mox-mox/moxens_ceiling_lamp/datasheets/AVR mit BTM-222 Class1 Bluetooth-Modul mit SPP firmware_files/USB-to-TTL-RS232-Converter_V2.jpg

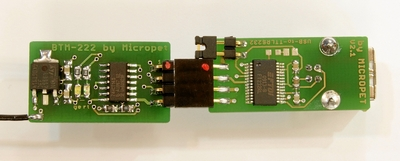
datasheets/AVR mit BTM-222 Class1 Bluetooth-Modul mit SPP firmware_files/USB-to-TTL-RS232-Converter_V2.jpg
