mox-mox/moxens_ceiling_lamp/README.md

moxens_ceiling_lamp
===================

This is the source to the lamp that is to light my room
