mox-mox/moxens_ceiling_lamp/datasheets/AVR mit BTM-222 Class1 Bluetooth-Modul mit SPP firmware_files/Basisboard%20BTM-222%20V2.png

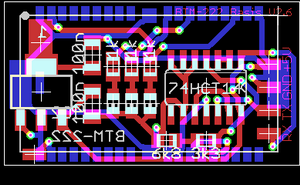
datasheets/AVR mit BTM-222 Class1 Bluetooth-Modul mit SPP firmware_files/Basisboard%20BTM-222%20V2.png
