mox-mox/moxens_ceiling_lamp/datasheets/AVR mit BTM-222 Class1 Bluetooth-Modul mit SPP firmware_files/Basisboard%2520BTM-222%2520V2_002.png

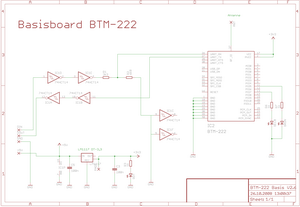
datasheets/AVR mit BTM-222 Class1 Bluetooth-Modul mit SPP firmware_files/Basisboard%2520BTM-222%2520V2_002.png
