mox-mox/moxens_ceiling_lamp/datasheets/AVR mit BTM-222 Class1 Bluetooth-Modul mit SPP firmware_files/BTM-222-Wannenstecker_02_m.jpg

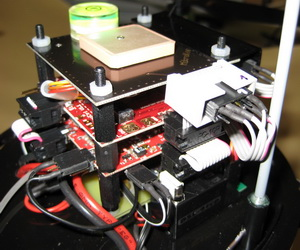
datasheets/AVR mit BTM-222 Class1 Bluetooth-Modul mit SPP firmware_files/BTM-222-Wannenstecker_02_m.jpg
