mox-mox/moxens_ceiling_lamp/hardware/Board.png

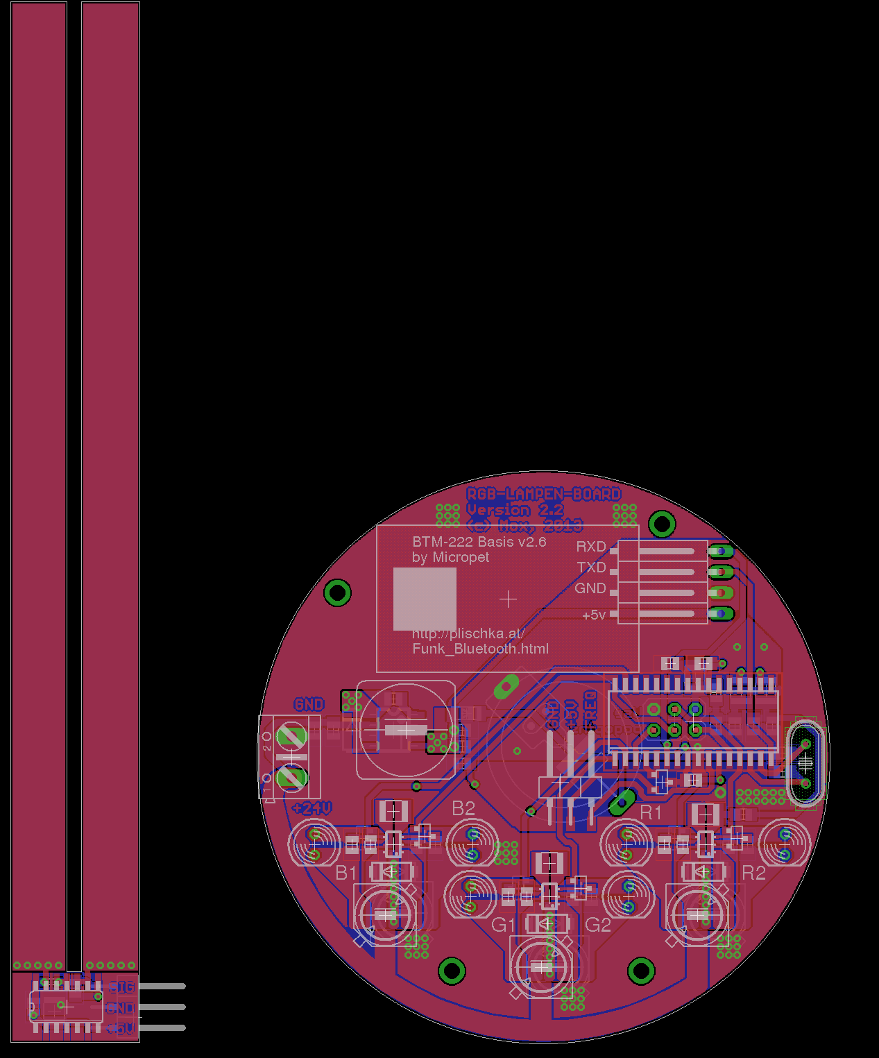
hardware/Board.png
