mox-mox/moxens_ceiling_lamp/hardware/plan.png

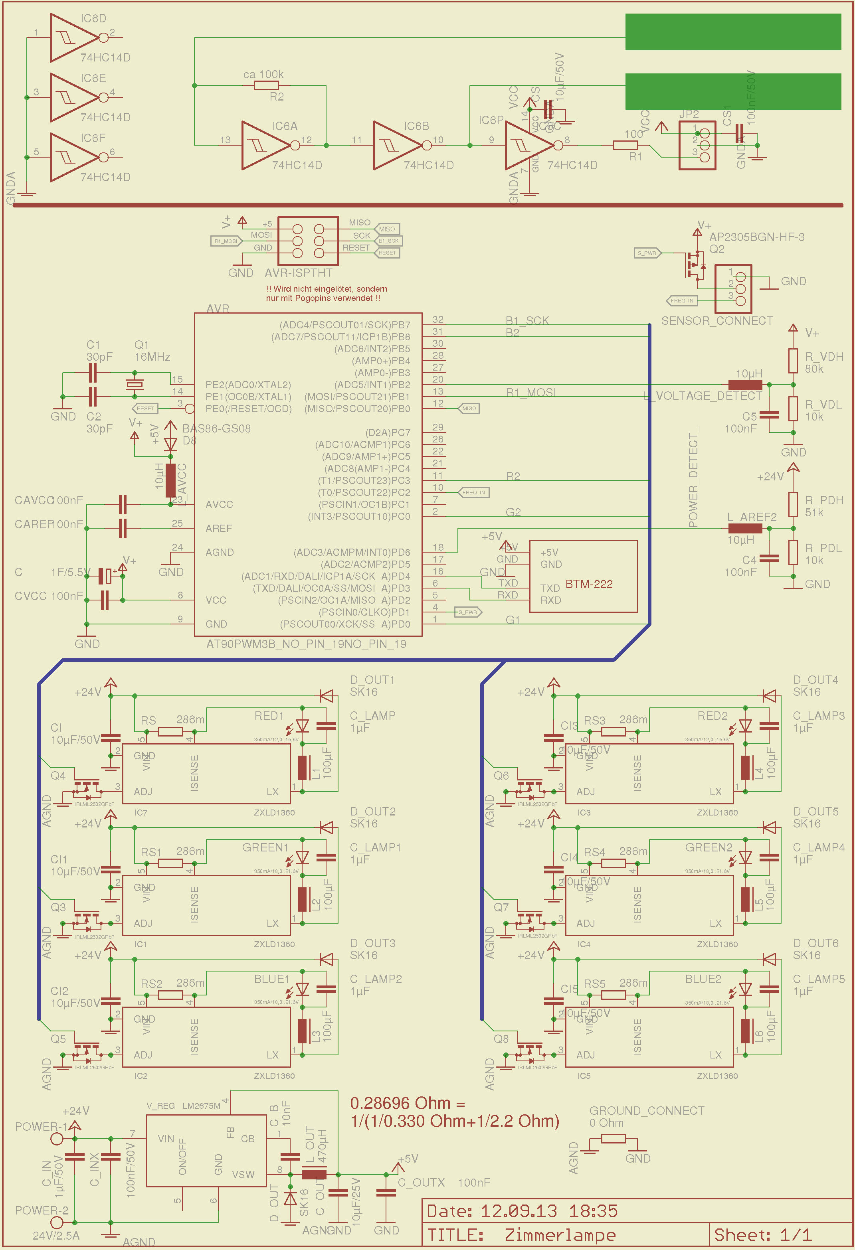
hardware/plan.png
