mox-mox/moxens_ceiling_lamp/hardware/Zimmerlampe_3.brd

## EAGLE design hardware/Zimmerlampe_3.brd (2014-02-08)

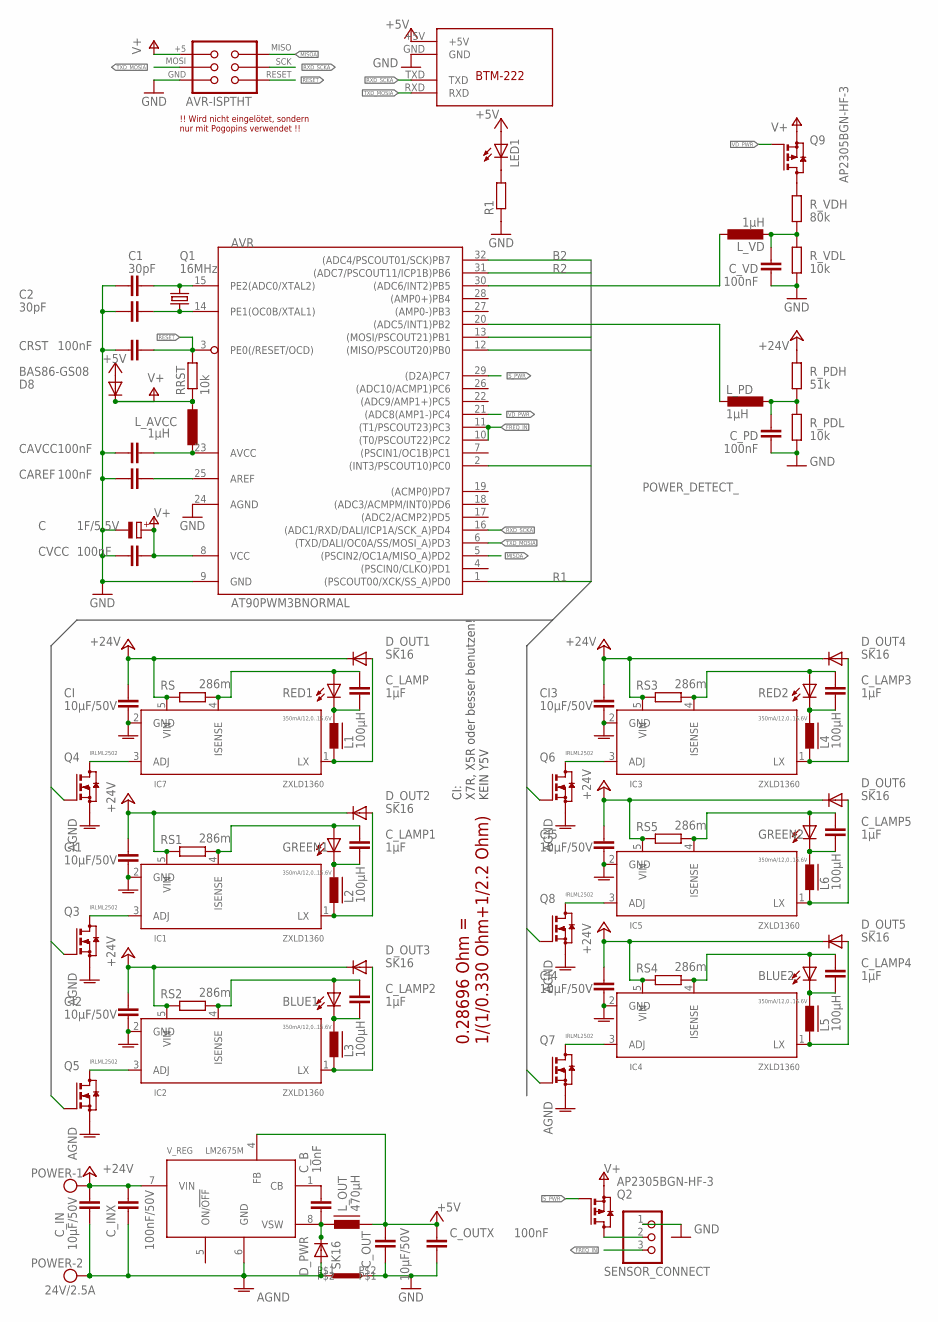
[picture p23: schematic Zimmerlampe_3.sch]

Parts:
AVR: AT90PWM3BNORMAL; SO32W
BLUE1, BLUE2: 350mA/12,0..15.6V; LED_CON
C: 1F/5.5V; PANASONIC_SG_TERMINAL_H
C1, C2: 30pF; C0805
CAREF: 100nF; C0805
CAVCC: 100nF; C0805
CI, CI1, CI2, CI3, CI4, CI5: 10µF/50V; C1210
CRST: 100nF; C0805
CVCC: 100nF; C0805
C_B: 10nF; C0805
C_IN: 10µF/50V; C1210
C_INX: 100nF/50V; C0805
C_LAMP, C_LAMP1, C_LAMP2, C_LAMP3, C_LAMP4, C_LAMP5: 1µF; C0805
C_OUT: 10µF/50V; C1210
C_OUTX: 100nF; C0805
C_PD: 100nF; C0805
C_VD: 100nF; C0805
D8: BAS86-GS08; MINIMELF
D_OUT1, D_OUT2, D_OUT3, D_OUT4, D_OUT5, D_OUT6: SK16; DO214AA
D_PWR: SK16; DO214AA
GREEN1, GREEN2: 350mA/12,0..15.6V; LED_CON
IC1, IC2, IC3, IC4, IC5, IC7: ZXLD1360; TSOT23-5
L1, L2, L3, L4, L5, L6: 100µH; FERROCORE_DER0705-
LED1: LEDSML0805; SML0805
L_AVCC: 1µH; L0805
L_OUT: 470µH; FERROCORE_DE1207-
L_PD: 1µH; L0805
L_VD: 1µH; L0805
POWER: 24V/2.5A; AK500/2
Q1: 16MHz; HC49/S
Q2, Q9: AP2305BGN-HF-3; SOT23
Q3, Q4, Q5, Q6, Q7, Q8: IRLML2502; SOT23
R1: R-EU_R0805; R0805
RED1, RED2: 350mA/12,0..15.6V; LED_CON
RRST: 10k; R0805
RS, RS1, RS2, RS3, RS4, RS5: 286m; R0805
R_PDH: 51k; R0805
R_PDL: 10k; R0805
R_VDH: 80k; R0805
R_VDL: 10k; R0805
SENSOR_CONNECT: 1X03SMD/90
U$1: BTM-222-BASIS; BTM-222
U$3: STARPOINT
U$7: AVR-ISPTHT; AVR-ISP-THT
V_REG: LM2675M; SO08

Connections:
+5V: C_OUT.1, C_OUTX.1, D8.A, LED1.A, L_OUT.P$2 (2), U$1.+5V, V_REG.4 (FB)
+24V: CI.1, CI1.1, CI2.1, CI3.1, CI4.1, CI5.1, C_IN.1, C_INX.1, D_OUT1.C, D_OUT2.C, D_OUT3.C, D_OUT4.C, D_OUT5.C, D_OUT6.C, IC1.5 (VIN), IC2.5 (VIN), IC3.5 (VIN), IC4.5 (VIN), IC5.5 (VIN), IC7.5 (VIN), POWER.1, RS.1, RS1.1, RS2.1, RS3.1, RS4.1, RS5.1, R_PDH.1, V_REG.7 (VIN)
ADJUST: IC7.3 (ADJ), Q4.3 (D)
ADJUST1: IC1.3 (ADJ), Q3.3 (D)
ADJUST2: IC2.3 (ADJ), Q5.3 (D)
ADJUST3: IC3.3 (ADJ), Q6.3 (D)
ADJUST4: IC4.3 (ADJ), Q7.3 (D)
ADJUST5: IC5.3 (ADJ), Q8.3 (D)
AGND: CI.2, CI1.2, CI2.2, CI3.2, CI4.2, CI5.2, C_IN.2, C_INX.2, D_PWR.A, IC1.2 (GND), IC2.2 (GND), IC3.2 (GND), IC4.2 (GND), IC5.2 (GND), IC7.2 (GND), POWER.2, Q3.2 (S), Q4.2 (S), Q5.2 (S), Q6.2 (S), Q7.2 (S), Q8.2 (S), U$3.P$1, V_REG.6 (GND)
AREF: AVR.25 (AREF), CAREF.2
AVCC: AVR.23 (AVCC), CAVCC.2, L_AVCC.1
B1: AVR.13 ((MOSI/PSCOUT21)PB1), Q5.1 (G)
B2: AVR.32 ((ADC4/PSCOUT01/SCK)PB7), Q7.1 (G)
BLUE2: BLUE2.A, C_LAMP4.1, IC4.4 (ISENSE), RS4.2
FREEWHEEL: D_OUT1.A, IC7.1 (LX), L1.P$2 (2)
FREEWHEEL1: D_OUT2.A, IC1.1 (LX), L2.P$2 (2)
FREEWHEEL2: D_OUT3.A, IC2.1 (LX), L3.P$2 (2)
FREEWHEEL3: D_OUT4.A, IC3.1 (LX), L4.P$2 (2)
FREEWHEEL4: D_OUT5.A, IC4.1 (LX), L5.P$2 (2)
FREEWHEEL5: D_OUT6.A, IC5.1 (LX), L6.P$2 (2)
FREQ_IN: AVR.10 ((T0/PSCOUT22)PC2), AVR.11 ((T1/PSCOUT23)PC3), SENSOR_CONNECT.3
G1: AVR.12 ((MISO/PSCOUT20)PB0), Q3.1 (G)
G2: AVR.2 ((INT3/PSCOUT10)PC0), Q8.1 (G)
GND: AVR.9 (GND), AVR.24 (AGND), C.-, C1.1, C2.1, CAREF.1, CAVCC.1, CRST.1, CVCC.1, C_OUT.2, C_OUTX.2, C_PD.2, C_VD.2, R1.1, R_PDL.2, R_VDL.2, SENSOR_CONNECT.1, U$1.GND, U$3.P$2, U$7.6 (GND)
MISOA: AVR.5 ((PSCIN2/OC1A/MISO_A)PD2), U$7.1 (MISO)
unnamed: LED1.C, R1.2
unnamed: C_LAMP.1, IC7.4 (ISENSE), RED1.A, RS.2
unnamed: C_LAMP.2, L1.P$1 (1), RED1.C
unnamed: Q9.2 (D), R_VDH.1
unnamed: C_LAMP1.2, GREEN1.C, L2.P$1 (1)
unnamed: C_LAMP1.1, GREEN1.A, IC1.4 (ISENSE), RS1.2
unnamed: BLUE1.C, C_LAMP2.2, L3.P$1 (1)
unnamed: BLUE1.A, C_LAMP2.1, IC2.4 (ISENSE), RS2.2
unnamed: C_LAMP3.2, L4.P$1 (1), RED2.C
unnamed: C_LAMP3.1, IC3.4 (ISENSE), RED2.A, RS3.2
unnamed: BLUE2.C, C_LAMP4.2, L5.P$1 (1)
unnamed: C_LAMP5.2, GREEN2.C, L6.P$1 (1)
unnamed: C_LAMP5.1, GREEN2.A, IC5.4 (ISENSE), RS5.2
unnamed: C_B.1, V_REG.1 (CB)
unnamed: Q2.2 (D), SENSOR_CONNECT.2
POWER_DETECT: C_PD.1, L_PD.1, R_PDH.2, R_PDL.1
POWER_DETECT_: AVR.20 ((ADC5/INT1)PB2), L_PD.2
R1: AVR.1 ((PSCOUT00/XCK/SS_A)PD0), Q4.1 (G)
R2: AVR.31 ((ADC7/PSCOUT11/ICP1B)PB6), Q6.1 (G)
RESET: AVR.3 (PE0(/RESET/OCD)), CRST.2, RRST.2, U$7.5 (RESET)
RXD_SCKA: AVR.16 ((ADC1/RXD/DALI/ICP1A/SCK_A)PD4), U$1.TXD, U$7.3 (SCK)
SWITCH: C_B.2, D_PWR.C, L_OUT.P$1 (1), V_REG.8 (VSW)
S_PWR: AVR.29 ((D2A)PC7), Q2.1 (G)
TXD_MOSIA: AVR.6 ((TXD/DALI/OC0A/SS/MOSI_A)PD3), U$1.RXD, U$7.4 (MOSI)
V+: AVR.8 (VCC), C.+, CVCC.2, D8.C, L_AVCC.2, Q2.3 (S), Q9.3 (S), RRST.1, U$7.2 (+5)
VD_PWR: AVR.21 ((ADC8(AMP1-)PC4), Q9.1 (G)
VOLTAGE_DETECT: C_VD.1, L_VD.2, R_VDH.2, R_VDL.1
VOLTAGE_DETECT_: AVR.30 ((ADC6/INT2)PB5), L_VD.1
XTAL1: AVR.14 (PE1(OC0B/XTAL1)), C2.2, Q1.2
XTAL2: AVR.15 (PE2(ADC0/XTAL2)), C1.2, Q1.1

Notes on the sheet:
0.28696 Ohm = 1/(1/0.330 Ohm+1/2.2 Ohm)
!! Wird nicht eingelötet, sondern nur mit Pogopins verwendet !!
CI: X7R, X5R oder besser benutzen! KEIN Y5V

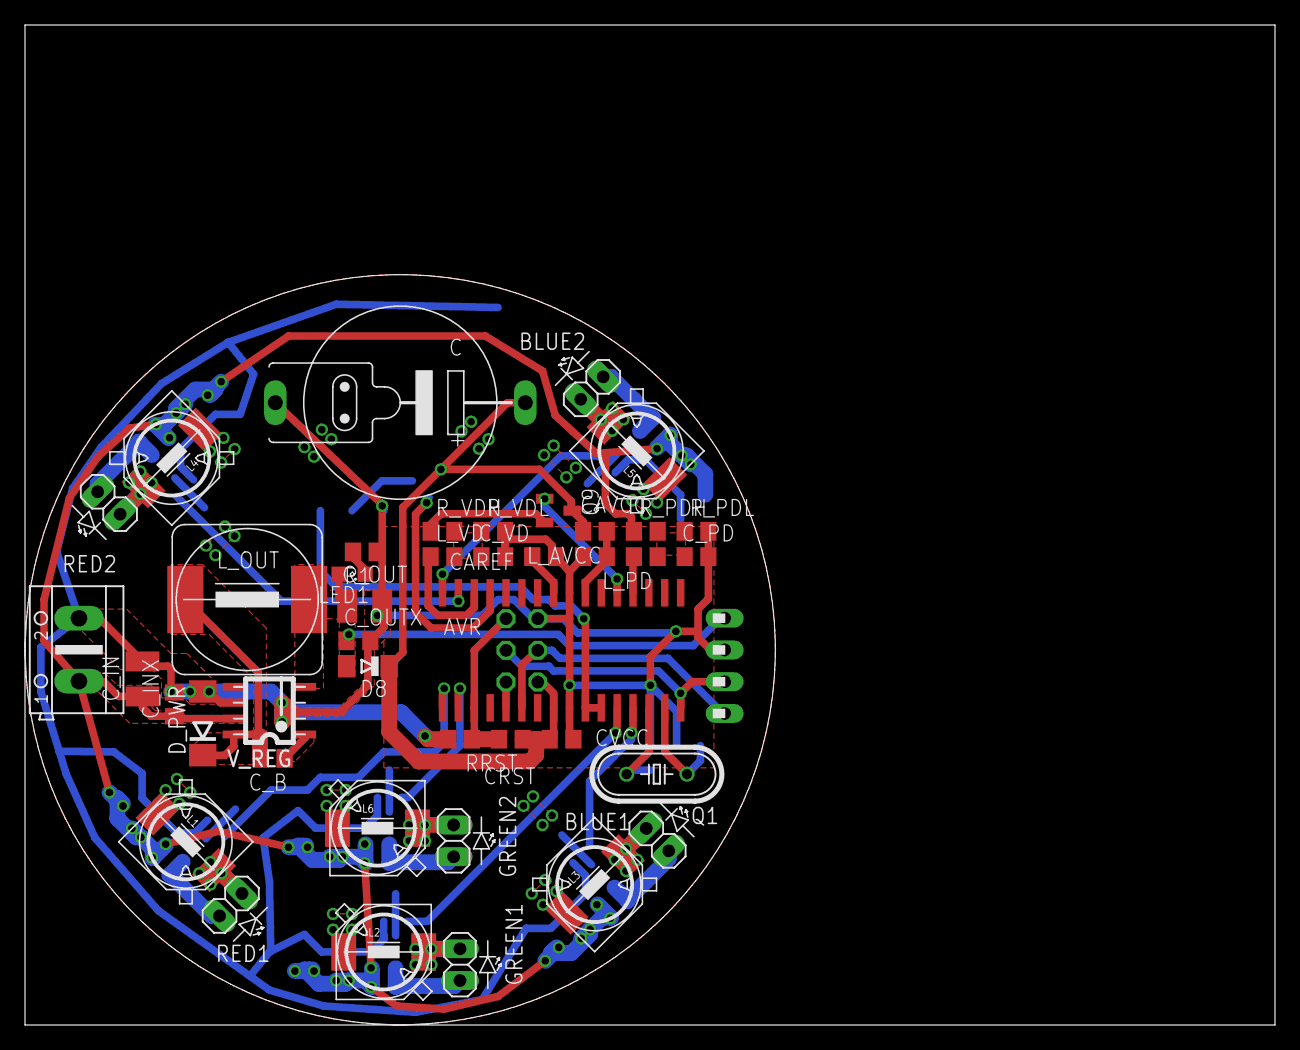
[picture p24: board Zimmerlampe_3.brd from above]

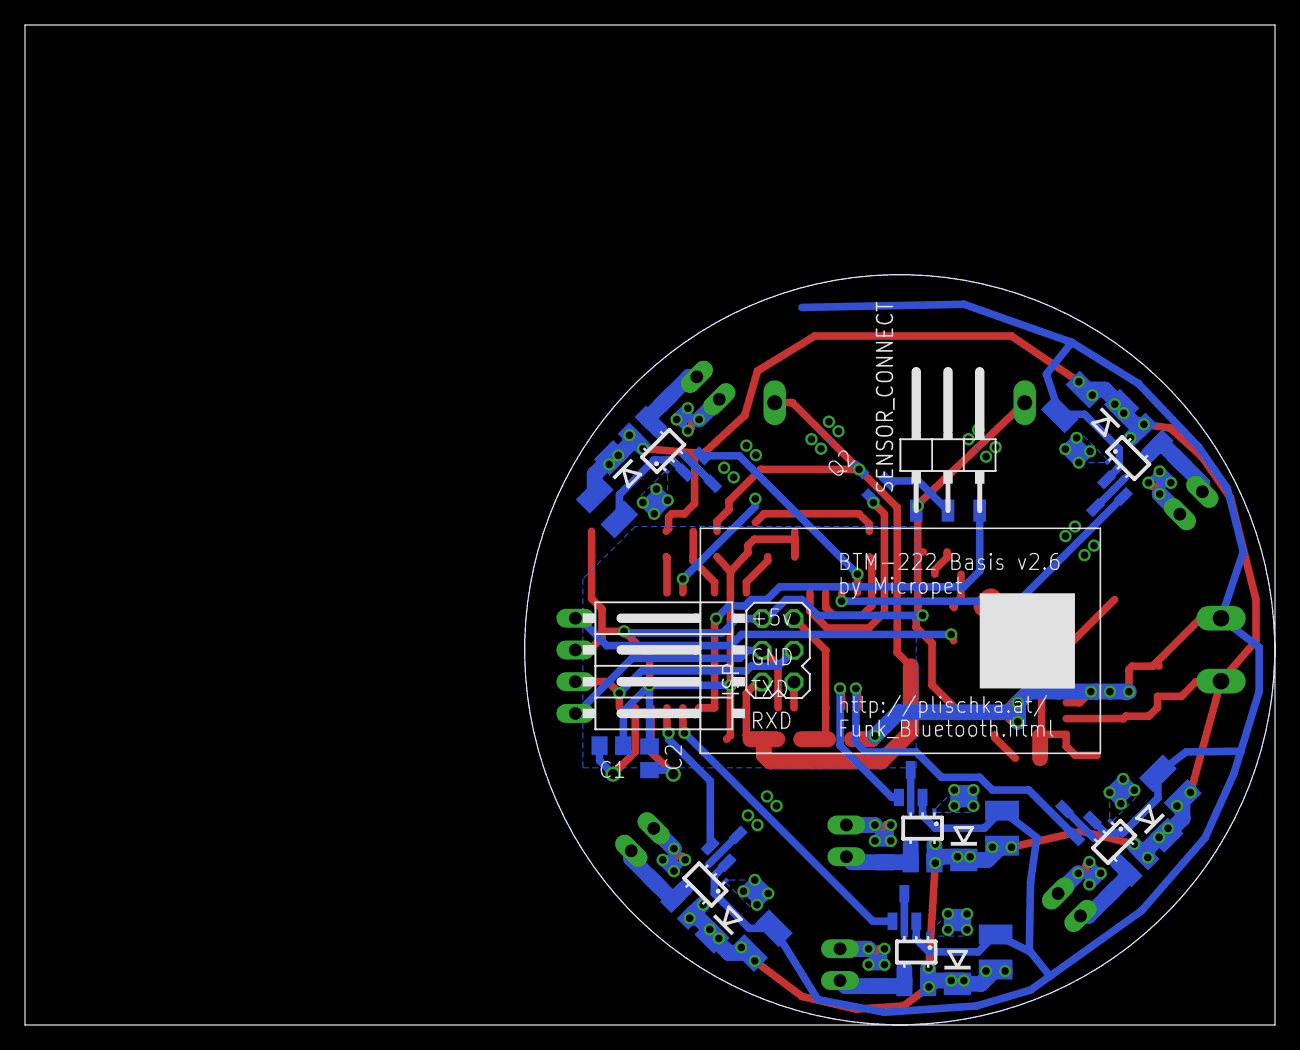
[picture p25: board Zimmerlampe_3.brd from below]

Board: 2 copper layers, 100.0 x 80.0 mm, 85 parts (43 on the bottom side), 55 nets.
