mox-mox/moxens_ceiling_lamp/hardware/Feuchtesensor_Frequenz.brd

## EAGLE design hardware/Feuchtesensor_Frequenz.brd (2014-01-29)

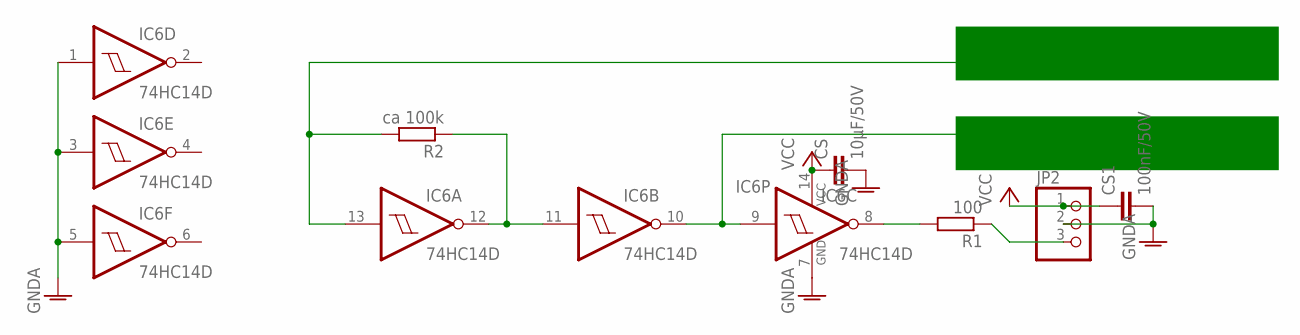
[picture p26: schematic Feuchtesensor_Frequenz.sch]

Parts:
CS: 10µF/50V; C1210
CS1: 100nF/50V; C0805
IC6: 74HC14D; SO14
JP2: 1X03SMD/90
R1: 100; R0805
R2: ca 100k; R0603

Connections:
GNDA: CS.2, CS1.2, IC6.1 (I), IC6.3 (I), IC6.5 (I), IC6.7 (GND), JP2.2
unnamed: IC6.13 (I), R2.2
unnamed: IC6.11 (I), IC6.12 (O), R2.1
unnamed: IC6.9 (I), IC6.10 (O)
SIG: JP2.3, R1.1
SIG_: IC6.8 (O), R1.2
VCC: CS.1, CS1.1, IC6.14 (VCC), JP2.1

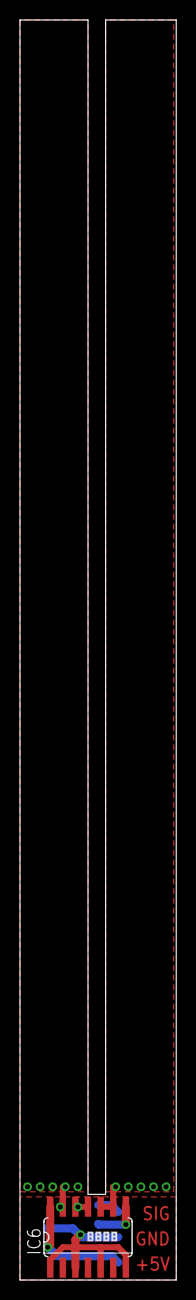
[picture p27: board Feuchtesensor_Frequenz.brd from above]

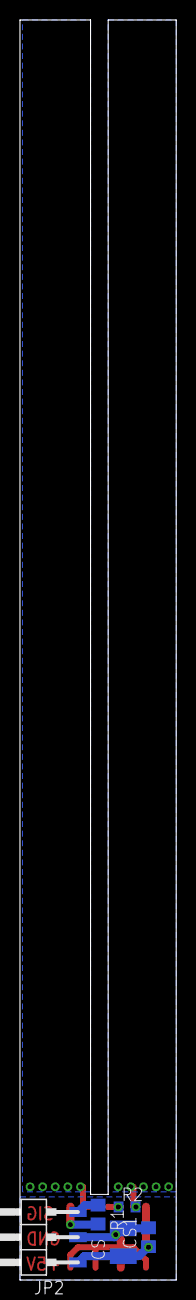
[picture p28: board Feuchtesensor_Frequenz.brd from below]

Board: 2 copper layers, 15.7 x 127.0 mm, 7 parts (5 on the bottom side), 7 nets.

Other parts of the board:
U$2: LP_NUMBER_SILK_TOP
