mox-mox/moxens_ceiling_lamp/hardware/Zimmerlampe_6.brd

## EAGLE design hardware/Zimmerlampe_6.brd (2014-02-27)

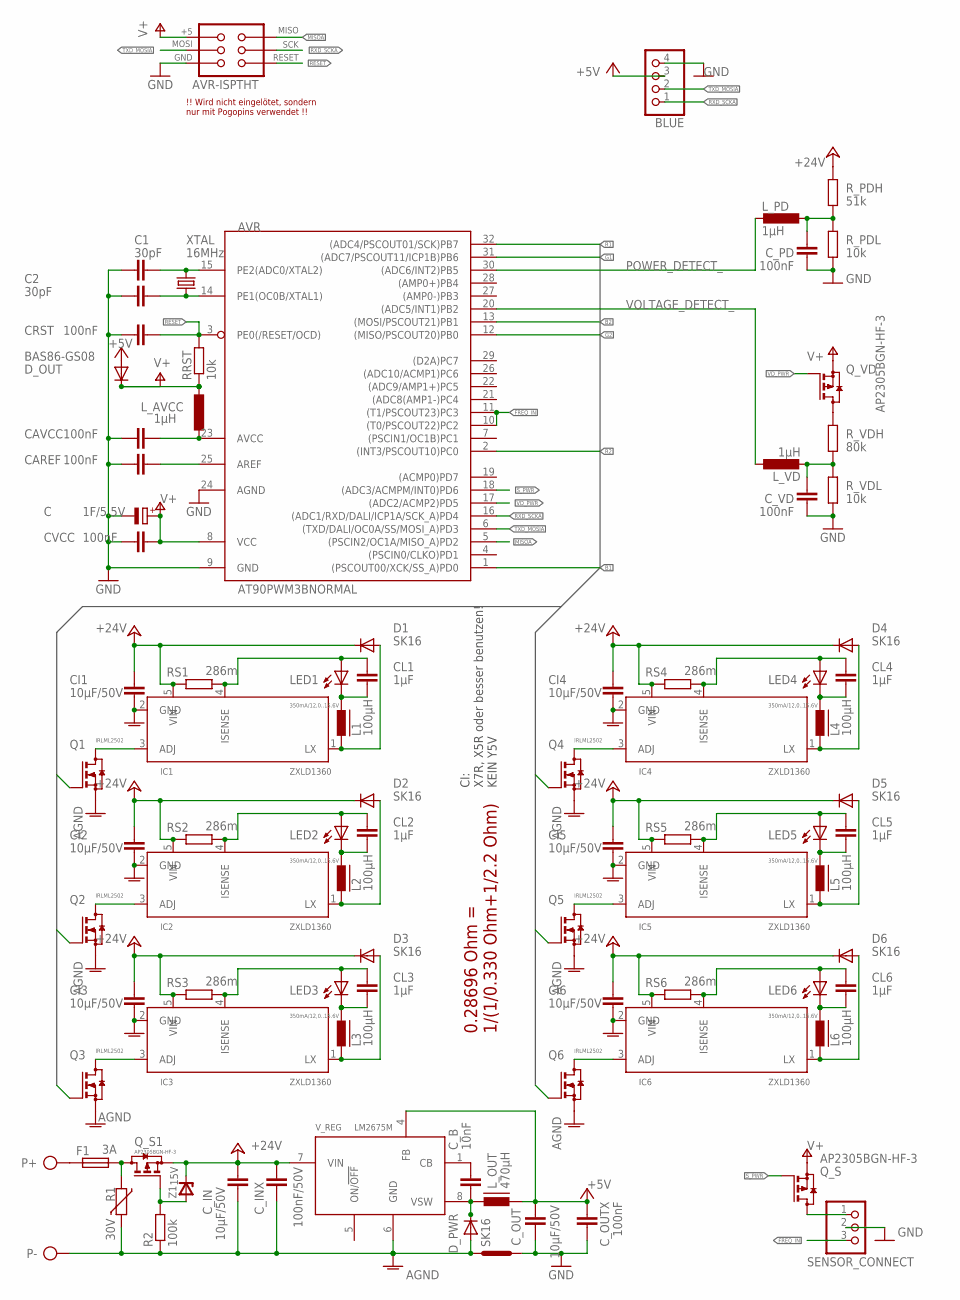
[picture p29: schematic Zimmerlampe_6.sch]

Parts:
AVR: AT90PWM3BNORMAL; SO32W
BLUE: PINHD-1X4_2.54-SMD-INLINE; 1X04SMD/INLINE
C: 1F/5.5V; PANASONIC_SG_TERMINAL_H
C1, C2: 30pF; C0805
CAREF: 100nF; C0805
CAVCC: 100nF; C0805
CI1, CI2, CI3, CI4, CI5, CI6: 10µF/50V; C1210
CL1, CL2, CL3, CL4, CL5, CL6: 1µF; C0805
CRST: 100nF; C0805
CVCC: 100nF; C0805
C_B: 10nF; C0805
C_IN: 10µF/50V; C1210
C_INX: 100nF/50V; C0805
C_OUT: 10µF/50V; C1210
C_OUTX: 100nF; C0805
C_PD: 100nF; C0805
C_VD: 100nF; C0805
D1, D2, D3, D4, D5, D6: SK16; DO214AA
D_OUT: BAS86-GS08; MINIMELF
D_PWR: SK16; DO214AA
F1: 3A; FUSE_1206
IC1, IC2, IC3, IC4, IC5, IC6: ZXLD1360; TSOT23-5
L1, L2, L3, L4, L5, L6: 100µH; FERROCORE_DER0705-
LED1, LED2, LED3, LED4, LED5, LED6: 350mA/12,0..15.6V; LED_CON_B
L_AVCC: 1µH; L0805
L_OUT: 470µH; FERROCORE_DE1207-
L_PD: 1µH; L0805
L_VD: 1µH; L0805
P+: POWER_VIAOCTA; POWER_VIA_OCTA
P-: POWER_VIAOCTA; POWER_VIA_OCTA
Q1, Q2, Q3, Q4, Q5, Q6: IRLML2502; SOT23
Q_S, Q_S1: AP2305BGN-HF-3; SOT23
Q_VD: AP2305BGN-HF-3; SOT23
R1: 30V; CT/CN1206
R2: 100k; R0805
RRST: 10k; R0805
RS1, RS2, RS3, RS4, RS5, RS6: 286m; R0805
R_PDH: 51k; R0805
R_PDL: 10k; R0805
R_VDH: 80k; R0805
R_VDL: 10k; R0805
SENSOR_CONNECT: 1X03SMD/INLINE
U$3: STARPOINT
U$7: AVR-ISPTHT; AVR-ISP-THT
V_REG: LM2675M; SO08
XTAL: 16MHz; HC49UP
Z1: 15V; ZENER_DIODE

Connections:
+5V: BLUE.3, C_OUT.1, C_OUTX.1, D_OUT.A, L_OUT.P$2 (2), V_REG.4 (FB)
+24V: CI1.1, CI2.1, CI3.1, CI4.1, CI5.1, CI6.1, C_IN.1, C_INX.1, D1.C, D2.C, D3.C, D4.C, D5.C, D6.C, IC1.5 (VIN), IC2.5 (VIN), IC3.5 (VIN), IC4.5 (VIN), IC5.5 (VIN), IC6.5 (VIN), Q_S1.3 (S), RS1.1, RS2.1, RS3.1, RS4.1, RS5.1, RS6.1, R_PDH.1, V_REG.7 (VIN), Z1.C
ADJUST1: IC1.3 (ADJ), Q1.3 (D)
ADJUST2: IC2.3 (ADJ), Q2.3 (D)
ADJUST3: IC3.3 (ADJ), Q3.3 (D)
ADJUST4: IC4.3 (ADJ), Q4.3 (D)
ADJUST5: IC5.3 (ADJ), Q5.3 (D)
ADJUST6: IC6.3 (ADJ), Q6.3 (D)
AGND: CI1.2, CI2.2, CI3.2, CI4.2, CI5.2, CI6.2, C_IN.2, C_INX.2, D_PWR.A, IC1.2 (GND), IC2.2 (GND), IC3.2 (GND), IC4.2 (GND), IC5.2 (GND), IC6.2 (GND), P-.P$1, Q1.2 (S), Q2.2 (S), Q3.2 (S), Q4.2 (S), Q5.2 (S), Q6.2 (S), R1.2, R2.1, U$3.P$1, V_REG.6 (GND)
ANODE1: CL1.1, IC1.4 (ISENSE), LED1.A, RS1.2
ANODE2: CL2.1, IC2.4 (ISENSE), LED2.A, RS2.2
ANODE3: CL3.1, IC3.4 (ISENSE), LED3.A, RS3.2
ANODE4: CL4.1, IC4.4 (ISENSE), LED4.A, RS4.2
ANODE5: CL5.1, IC5.4 (ISENSE), LED5.A, RS5.2
ANODE6: CL6.1, IC6.4 (ISENSE), LED6.A, RS6.2
AREF: AVR.25 (AREF), CAREF.2
AVCC: AVR.23 (AVCC), CAVCC.2, L_AVCC.1
B1: AVR.1 ((PSCOUT00/XCK/SS_A)PD0), Q4.1 (G)
B2: AVR.13 ((MOSI/PSCOUT21)PB1), Q1.1 (G)
CATHODE1: CL1.2, L1.P$1 (1), LED1.C
CATHODE2: CL2.2, L2.P$1 (1), LED2.C
CATHODE3: CL3.2, L3.P$1 (1), LED3.C
CATHODE4: CL4.2, L4.P$1 (1), LED4.C
CATHODE5: CL5.2, L5.P$1 (1), LED5.C
CATHODE6: CL6.2, L6.P$1 (1), LED6.C
FREEWHEEL1: D1.A, IC1.1 (LX), L1.P$2 (2)
FREEWHEEL2: D2.A, IC2.1 (LX), L2.P$2 (2)
FREEWHEEL3: D3.A, IC3.1 (LX), L3.P$2 (2)
FREEWHEEL4: D4.A, IC4.1 (LX), L4.P$2 (2)
FREEWHEEL5: D5.A, IC5.1 (LX), L5.P$2 (2)
FREEWHEEL6: D6.A, IC6.1 (LX), L6.P$2 (2)
FREQ_IN: AVR.10 ((T0/PSCOUT22)PC2), AVR.11 ((T1/PSCOUT23)PC3), SENSOR_CONNECT.3
G1: AVR.31 ((ADC7/PSCOUT11/ICP1B)PB6), Q5.1 (G)
G2: AVR.12 ((MISO/PSCOUT20)PB0), Q2.1 (G)
GND: AVR.9 (GND), AVR.24 (AGND), BLUE.4, C.-, C1.1, C2.1, CAREF.1, CAVCC.1, CRST.1, CVCC.1, C_OUT.2, C_OUTX.2, C_PD.2, C_VD.2, R_PDL.2, R_VDL.2, SENSOR_CONNECT.2, U$3.P$2, U$7.6 (GND)
MISOA: AVR.5 ((PSCIN2/OC1A/MISO_A)PD2), U$7.1 (MISO)
unnamed: Q_VD.2 (D), R_VDH.1
unnamed: F1.2, Q_S1.2 (D), R1.1
unnamed: Q_S1.1 (G), R2.2, Z1.A
unnamed: F1.1, P+.P$1
unnamed: C_B.1, V_REG.1 (CB)
POWER_DETECT: C_PD.1, L_PD.1, R_PDH.2, R_PDL.1
POWER_DETECT_: AVR.30 ((ADC6/INT2)PB5), L_PD.2
R1: AVR.32 ((ADC4/PSCOUT01/SCK)PB7), Q6.1 (G)
R2: AVR.2 ((INT3/PSCOUT10)PC0), Q3.1 (G)
RESET: AVR.3 (PE0(/RESET/OCD)), CRST.2, RRST.2, U$7.5 (RESET)
RXD_SCKA: AVR.16 ((ADC1/RXD/DALI/ICP1A/SCK_A)PD4), BLUE.1, U$7.3 (SCK)
SENSOR_POWER: Q_S.2 (D), SENSOR_CONNECT.1
SWITCH: C_B.2, D_PWR.C, L_OUT.P$1 (1), V_REG.8 (VSW)
S_PWR: AVR.18 ((ADC3/ACMPM/INT0)PD6), Q_S.1 (G)
TXD_MOSIA: AVR.6 ((TXD/DALI/OC0A/SS/MOSI_A)PD3), BLUE.2, U$7.4 (MOSI)
V+: AVR.8 (VCC), C.+, CVCC.2, D_OUT.C, L_AVCC.2, Q_S.3 (S), Q_VD.3 (S), RRST.1, U$7.2 (+5)
VD_PWR: AVR.17 ((ADC2/ACMP2)PD5), Q_VD.1 (G)
VOLTAGE_DETECT: C_VD.1, L_VD.2, R_VDH.2, R_VDL.1
VOLTAGE_DETECT_: AVR.20 ((ADC5/INT1)PB2), L_VD.1
XTAL1: AVR.14 (PE1(OC0B/XTAL1)), C2.2, XTAL.2
XTAL2: AVR.15 (PE2(ADC0/XTAL2)), C1.2, XTAL.1

Notes on the sheet:
0.28696 Ohm = 1/(1/0.330 Ohm+1/2.2 Ohm)
!! Wird nicht eingelötet, sondern nur mit Pogopins verwendet !!
CI: X7R, X5R oder besser benutzen! KEIN Y5V

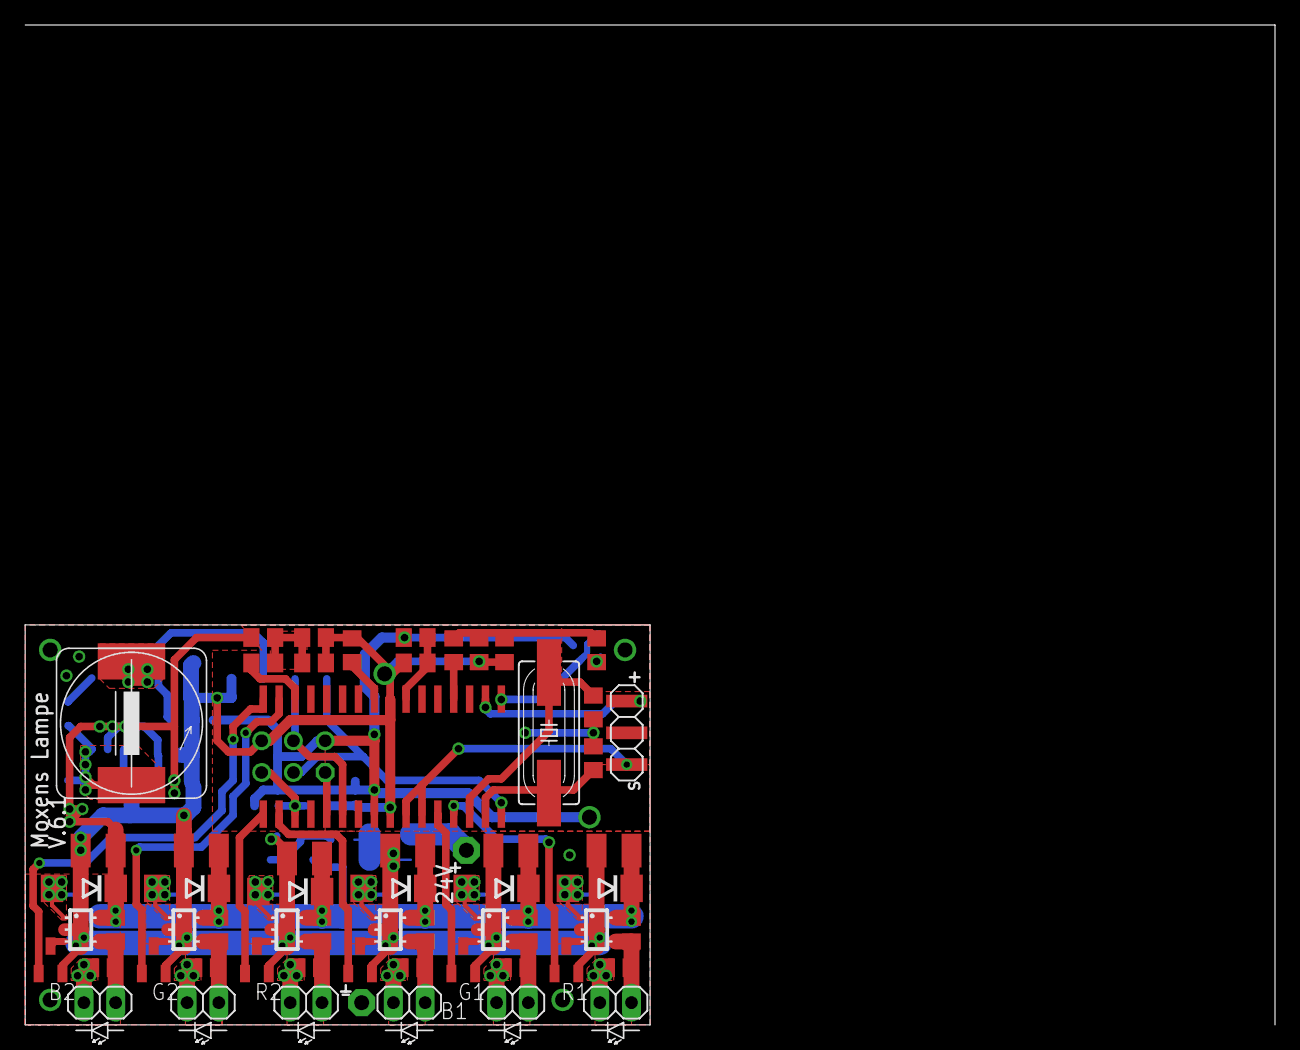
[picture p30: board Zimmerlampe_6.brd from above]

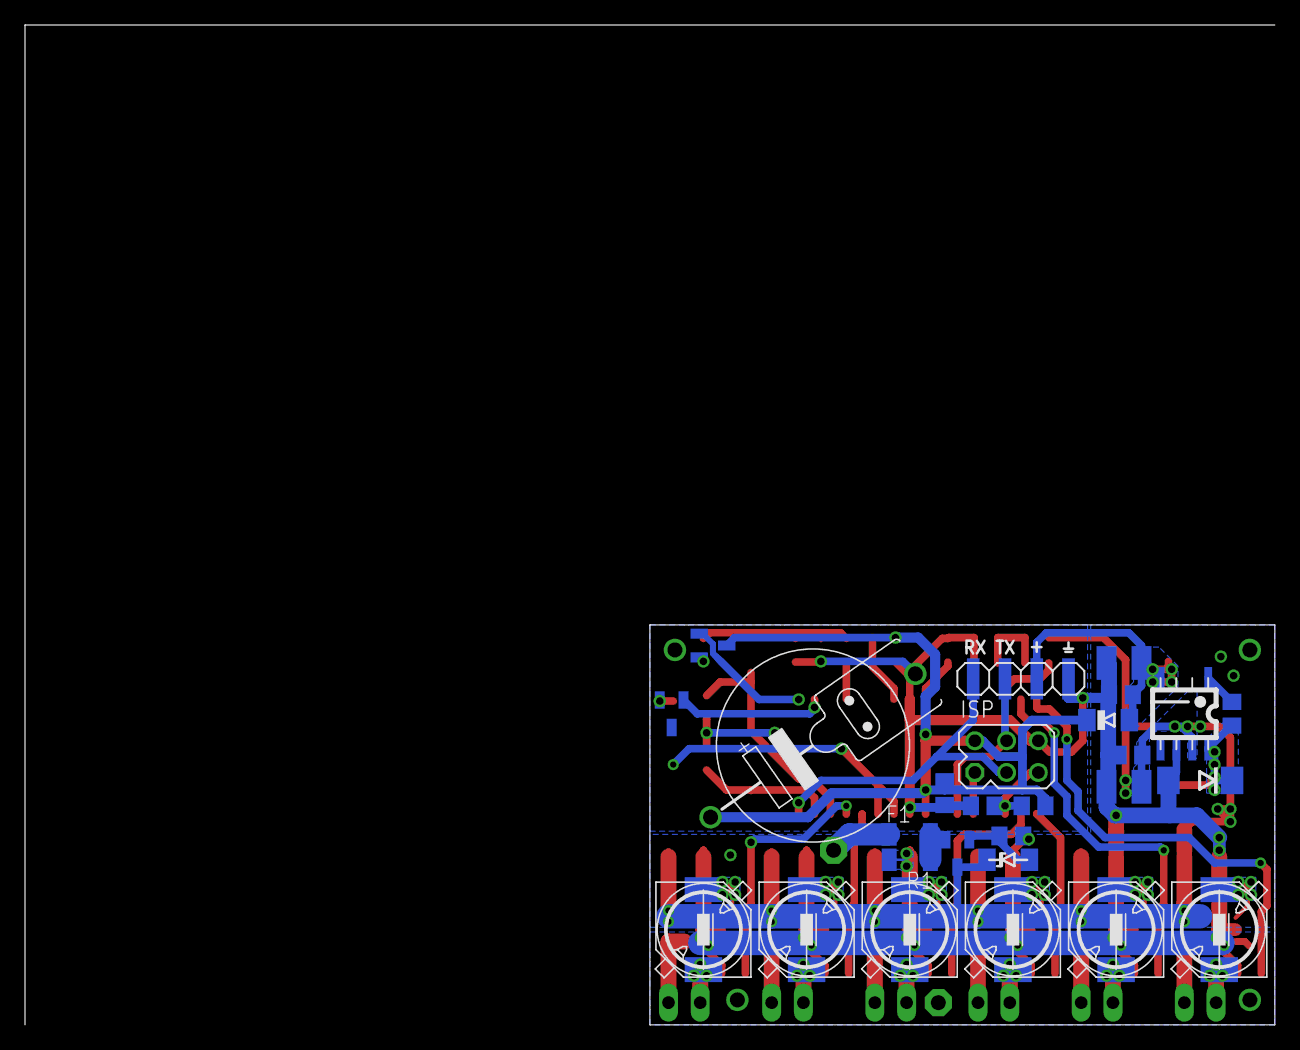
[picture p31: board Zimmerlampe_6.brd from below]

Board: 2 copper layers, 50.0 x 32.0 mm, 89 parts (28 on the bottom side), 57 nets.
