mox-mox/moxens_ceiling_lamp/code/pc/main.cpp

#include <SerialStream.h>
#include <iostream>
#include <unistd.h>
#include <cstdlib>

int main(int argc, char** argv)
{
	if ( argc < 2 )
	{
		std::cerr << "Usage: " << argv[0] << " <your_tty>" << std::endl;
		std::cerr << "Example: " <<argv[0] << "ttyUSB0" << std::endl;
		return 1;
	}
	//
	// Open the serial port.
	//
	using namespace LibSerial;
	SerialStream serial_port;
	std::string portname(argv[1]);
	serial_port.Open("/dev/"+portname);
	if ( !serial_port.good())
	{
		std::cerr << "[" << __FILE__ << ":" << __LINE__ << "] "
		          << "Error: Could not open serial port."
		          << std::endl;
		exit(1);
	}
	//
	// Set the baud rate of the serial port.
	//
	serial_port.SetBaudRate(SerialStreamBuf::BAUD_4800);
	if ( !serial_port.good())
	{
		std::cerr << "Error: Could not set the baud rate." << std::endl;
		exit(1);
	}
	//
	// Set the number of data bits.
	//
	serial_port.SetCharSize(SerialStreamBuf::CHAR_SIZE_8);
	if ( !serial_port.good())
	{
		std::cerr << "Error: Could not set the character size." << std::endl;
		exit(1);
	}
	//
	// Disable parity.
	//
	serial_port.SetParity(SerialStreamBuf::PARITY_NONE);
	if ( !serial_port.good())
	{
		std::cerr << "Error: Could not disable the parity." << std::endl;
		exit(1);
	}
	//
	// Set the number of stop bits.
	//
	serial_port.SetNumOfStopBits(1);
	if ( !serial_port.good())
	{
		std::cerr << "Error: Could not set the number of stop bits."
		          << std::endl;
		exit(1);
	}
	//
	// Turn off hardware flow control.
	//
	serial_port.SetFlowControl(SerialStreamBuf::FLOW_CONTROL_NONE);
	if ( !serial_port.good())
	{
		std::cerr << "Error: Could not use hardware flow control."
		          << std::endl;
		exit(1);
	}
	//
	// Do not skip whitespace characters while reading from the
	// serial port.
	//
	serial_port.unsetf(std::ios_base::skipws);
	//
	// Wait for some data to be available at the serial port.
	//
	while( serial_port.rdbuf()->in_avail() == 0 )
	{
		usleep(100);
		serial_port<<1<<std::endl;
		serial_port<<1<<std::endl;
		serial_port<<1<<std::endl;
		serial_port<<1<<std::endl;
		serial_port<<1<<std::endl;
	}
	//
	// Keep reading data from serial port and print it to the screen.
	//
	while( serial_port.rdbuf()->in_avail() > 0  )
	{
		char next_byte;
		serial_port.get(next_byte);
		std::cerr << std::hex << static_cast<int>(next_byte) << " ";
		usleep(100);
	}
	std::cerr << std::endl;
	return EXIT_SUCCESS;
}
