mox-mox/moxens_ceiling_lamp/code/mc/communication.c

#include "communication.h"
#include "main.h"
#include <avr/io.h>
#include <avr/interrupt.h>
#include "humidity.h"
#include "colours.h"

inline void handle_command(instruction command, uint8_t data[3]);

//{{{
void init_communication()
{
	EUCSRB=0;	// Disable the extended USART

	UBRRH=0;	// This SHOULD be 9600 baud at F_CPU=2MHz, but for some wicked reason it is 4800 baud...
	UBRRL=12;	// This SHOULD be 9600 baud at F_CPU=2MHz, but for some wicked reason it is 4800 baud...

	UCSRA = (1<<TXC) | (0<<U2X)    | (0<<MPCM);													// no U2X, no MPCM
	UCSRB = (1<<RXCIE)  | (0<<TXCIE) | (1<<UDRIE) | (1<<RXEN) | (1<<TXEN)  | (0<<UCSZ2);	// Receive Interrupt, Data Empty Interrupt RX and TX set
	//UCSRC = (0<<UMSEL0) | (1<<UPM1)  | (1<<UPM0)  | (1<<USBS) | (1<<UCSZ1) | (1<<UCSZ0) | (0<<UCPOL);	// Async, odd parity, 2 stop bits, 8-bit frames
	UCSRC = (0<<UMSEL0) | (0<<UPM1)  | (0<<UPM0)  | (0<<USBS) | (1<<UCSZ1) | (1<<UCSZ0) | (0<<UCPOL);	// Async, no parity, 1 stop bits, 8-bit frames
}
//}}}


ISR(USART_RX_vect)
{
	static uint8_t state=0;
	static uint8_t command=0;
	static uint8_t data[3]={0,0,0};
	static uint8_t received_byte=0;

	//{{{
	//Read Error codes and put the byte into the buffer
	if(UCSRA & ((1<<FE) | (1<<DOR) | (1<<UPE)))					// If there is a frame- or parity- or overrun- error...
	{
		state=0;												// ...drop this packet
		received_byte=UDR;										// read this to avoid a data overrun error from the next byte
		return;
	}
	received_byte=UDR;
	//UDR=received_byte;	// remove! This is here to test the pc terminal program
	switch(state)
	{
		case 0:													// 1st start bit
		case 1:													// 2nd start bit
			if(received_byte == STARTBYTE) state++;
			else state=0;
			break;
		case 2:													// Command
			command=received_byte;
			state++;
			break;
		case 3:
			data[0]=received_byte;
			state++;
			break;
		case 4:
			data[1]=received_byte;
			state++;
			break;
		case 5:
			data[2]=received_byte;
			state++;
			break;
		case 6:														// Checksum
			state=0;
			if((command+data[0]+data[1]+data[2]) == received_byte)// valid checksum
			{
				send_command(ack, data);						// remove
				handle_command(command, data);
			}
			else												// remove
			{													// remove
				send_command(nak, data);						// remove
			}													// remove
		default:		// WTF happened?
			state=0;
			break;
	}
	//}}}
}


#define TX_FIFO_SIZE 8	// Must be a power of 2
volatile uint8_t commands_to_send[TX_FIFO_SIZE][4]=
{{ 1,1,1,1},
 { 2,2,2,2},
 { 3,3,3,3},
 { 4,4,4,4},
 { 5,5,5,5},
 { 6,6,6,6},
 { 7,7,7,7},
 { 8,8,8,8}};
volatile uint8_t tx_write_index=0;
volatile uint8_t tx_read_index;
volatile uint8_t tx_fifo_crash_flag = 0;
//{{{
void send_command(instruction command, const uint8_t data[3])
{
	uint8_t sreg=SREG;
	cli();
	//tx_write_index++;
	//tx_write_index &= (TX_FIFO_SIZE-1);							// increment with overflow
	//if(tx_write_index==tx_read_index) tx_fifo_crash_flag=1;	//TODO: Is there an off-by-one-error?
	commands_to_send[tx_write_index][0]=(uint8_t) command;
	commands_to_send[tx_write_index][1]=data[0];
	commands_to_send[tx_write_index][2]=data[1];
	commands_to_send[tx_write_index][3]=data[2];
	tx_write_index++;
	tx_write_index &= (TX_FIFO_SIZE-1);							// increment with overflow
	if(tx_write_index==tx_read_index) tx_fifo_crash_flag=1;	//TODO: Is there an off-by-one-error?
	SREG=sreg;
	SBIT(UCSRB, UDRIE) = 1;										// Enable sending by enabling the UDR_empty interrupt
}
//}}}






ISR(USART_UDRE_vect)
{
	static volatile uint8_t state=0;
	static volatile uint8_t command;
	static volatile uint8_t data[3];

	//{{{
	switch(state)
	{
		case 0:
			// abuse command to hold a temporary variable to avoid creating a stack frame
			command = (tx_read_index+1) & (TX_FIFO_SIZE-1);
			if(command == tx_write_index)						// If the buffer is empty... // TODO: Is there an off-by-one-error?
			{
				//UDR=127; debug stuff
				SBIT(UCSRB, UDRIE) = 0;							// ...disable this interrupt...
				return;
			}
			tx_read_index = command;						// command contains the incremented address //TODO: Should the adress be incremented after reading?
			command = commands_to_send[tx_read_index][0];	// All
			data[0] = commands_to_send[tx_read_index][1];	// hail the
			data[1] = commands_to_send[tx_read_index][2];	// double
			data[2] = commands_to_send[tx_read_index][3];	// buffer!!
			//UDR=tx_read_index;	debug stuff
			//state++;
			//break;
		// note the case fall through...
		case 1:
			UDR=STARTBYTE;
			state++;
			break;
		case 2:
			UDR=command;
			state++;
			break;
		case 3:
			UDR=data[0];
			state++;
			break;
		case 4:
			UDR=data[1];
			state++;
			break;
		case 5:
			UDR=data[2];
			state++;
			break;
		case 6:
			UDR=command+data[0]+data[1]+data[2];				// send the checksum
			state=0;
			break;
		default:		// WTF happened?
			state=0;
			break;
	}
	//}}}
}






inline void handle_command(instruction command, uint8_t data[3])
{
	sei();							// Handle commands while allowing interrupts
	//{{{
	switch(command)	// TODO: Update this section
	{
		case nak:
		case ack:
			break;
		//{{{
		case humidity:
			measure_humidity();
			break;
		//}}}

		//{{{
		case on_off:
			if(!data[0])				// Data == 0 means "Lights off NOW!"
			{
				stop_psc();			// Turn the light off completely
			}
			else					// Data > 0 asks for the lights to be turned back on
			{
				start_psc();		// Turn the lights on
				if(data[0] > 1)				// Data > 1 requests full brightness
				{
					R1=0x0FFF;		// Set
					G1=0x0FFF;		// all
					B1=0x0FFF;		// channels
					R2=0x0FFF;		// to
					G2=0x0FFF;		// maximum
					B2=0x0FFF;		// brightness
				}
			}
			break;
		//}}}

		//{{{
		case set_rgb:
			set_rgb1_values(data);
			set_rgb2_values(data);
			break;
		//}}}

		//{{{
		case set_rgb1:
			set_rgb1_values(data);
			break;
		case set_rgb2:
			set_rgb2_values(data);
			break;
		//}}}

		//{{{
		case get_rgb1:
			get_rgb1_value2(data);
			send_command(set_rgb1, data);
			break;
		case get_rgb2:
			get_rgb1_value2(data);
			send_command(set_rgb1, data);
			break;
		//}}}
		default:
			break;
	}
	//}}}
}
