mox-mox/moxens_ceiling_lamp/(commit log)

2013-08-22 last commit with cat4101 - They seem to be linear regulators and therefore not suited
    [Zimmerlampe.brd, Zimmerlampe.sch]
2013-08-22 fixed net naming, added Datasheets
    [Zimmerlampe.brd, Zimmerlampe.sch]
2013-08-23 Switched to ZXLD1360 led driver
    [Zimmerlampe.brd, Zimmerlampe.sch]
2013-08-26 using zxld1360 to drive the leds now, added connection for humidity sensor for the plants
    [Zimmerlampe.brd, Zimmerlampe.sch]
2013-08-27 Final version? Added moisture sensor
    [Zimmerlampe.brd, Zimmerlampe.sch]
2013-08-27 cleared up schematic, replaced pipolar adj-drivers with unipoloar ones, seperated the unused output pins on the sensor from ground
    [Zimmerlampe.brd, Zimmerlampe.sch]
2013-08-27 corrected connections of Q2
    [Zimmerlampe.brd, Zimmerlampe.sch]
2013-08-30 added some values, replaced one diode, moved everything to accomodate bigger cases for the 10µF/50V capacitors
    [Zimmerlampe.brd, Zimmerlampe.sch]
2013-08-31 minor bugfixes
    [Zimmerlampe.brd, Zimmerlampe.sch]
2013-09-05 minor move of the avrs block capacitor
    [Zimmerlampe.brd, Zimmerlampe.sch]
2013-09-07 moved the support capacito® into the middle
    [Zimmerlampe.brd, Zimmerlampe.sch]
2013-09-10 added gnd-pane, improved acces to the 24V for the bottom side led drivers
    [Zimmerlampe.brd, Zimmerlampe.sch]
2013-09-12 resized the gnd-layer on top
    [Zimmerlampe.brd, Zimmerlampe.sch]
2013-09-12 minor improvements
    [Zimmerlampe.brd]
2013-09-12 minor fixes, copied design into sensor board and driver board for ordering
    [Feuchtesensor_Frequenz.brd, Feuchtesensor_Frequenz.sch, RGB_Lampen_Board.brd, RGB_Lampen_Board.sch]
2013-09-12 added identifier field to the layout as needed for ordering with platinensammler
    [Feuchtesensor_Frequenz.brd, RGB_Lampen_Board.brd]
2014-01-29 update and BOM
    [Feuchtesensor_Frequenz.brd, RGB_Lampen_Board.brd, Zimmerlampe.brd, Zimmerlampe.sch]
2014-01-29 changed inductance for connections to the avr to 1µH as bigger ones are not available
    [Zimmerlampe.brd, Zimmerlampe.sch]
2014-02-04 added data for the sensor, started writing some very simple code. Makefile taken for the robotics laboratory of the University of Heidelberg
    [Zimmerlampe.brd, Zimmerlampe.sch]
2014-02-07 ISP connections were wrong. Overhauling and correcting..
    [Zimmerlampe_2.brd, Zimmerlampe_2.sch, Zimmerlampe_3.brd, Zimmerlampe_3.sch]
2014-02-07 some progress, I might try another layout now..
    [Zimmerlampe_3.brd, Zimmerlampe_3.sch]
2014-02-08 wip 2
    [Zimmerlampe_3.brd, Zimmerlampe_3.sch]
2014-02-08 minor changes, added ground pane v+
    [Zimmerlampe_3.brd]
2014-02-08 The design should be finished now, except for the silkscreen which needs more refinement. I will look after this later on
    [Zimmerlampe_3.brd, Zimmerlampe_3.sch]
2014-02-09 trying to reduce the space..
    [Zimmerlampe_4.brd, Zimmerlampe_4.sch]
2014-02-09 still a work in progress
    [Zimmerlampe_4.brd, Zimmerlampe_4.sch]
2014-02-10 Finished layout of 4th version
    [Zimmerlampe_4.brd, Zimmerlampe_4.sch]
2014-02-11 some refinements
    [Zimmerlampe_4.brd, Zimmerlampe_4.sch]
2014-02-12 added power led to v+
    [Zimmerlampe_4.brd, Zimmerlampe_4.sch]
2014-02-15 some small changes and improvements
    [Zimmerlampe_4.brd, Zimmerlampe_4.sch]
2014-02-16 started writing the code for the lamp
    [Zimmerlampe_4.sch]
2014-02-23 changed the width of the polygons to 8 mil
    [Zimmerlampe_4.brd]
2014-02-23 added 5th version. The drivers are rotated by 180 degrees which is advantageous
    [Zimmerlampe_5.brd, Zimmerlampe_5.sch]
2014-02-23 some improvements in the power routing
    [Zimmerlampe_5.brd, Zimmerlampe_5.sch]
2014-02-23 Some more improvements in the power routing. Final version?
    [Zimmerlampe_5.brd, Zimmerlampe_5.sch]
2014-02-24 Split the connections for T0 and T1, so one can be truncated later. Final version?
    [Zimmerlampe_5.brd]
2014-02-25 unresolvable bug in version 5, started version6
    [Zimmerlampe_6.brd, Zimmerlampe_6.sch]
2014-02-25 redoing everything...
    [Zimmerlampe_6.brd, Zimmerlampe_6.sch]
2014-02-26 The power-segment of the board needs to be mirrored, I missed this while layouting :(
    [Zimmerlampe_6.brd, Zimmerlampe_6.sch]
2014-02-26 finishing version 6
    [Zimmerlampe_6.brd, Zimmerlampe_6.sch]
2014-02-26 adding cool, hopefully final version 6
    [Zimmerlampe_6.brd, Zimmerlampe_6.sch]
2014-02-26 moved version 6 to 7 to prepare merging
    [Zimmerlampe_7.brd, Zimmerlampe_7.sch]
2014-02-26 final touches to version 6. Version 7 is a dead end.
    [Zimmerlampe_6.brd, Zimmerlampe_6.sch, Zimmerlampe_7.sch]
2014-02-26 Some more improvements
    [Zimmerlampe_6.brd, Zimmerlampe_6.sch]
2014-02-26 added overvoltage, overcurrent and reverse voltage protection
    [Zimmerlampe_6.brd, Zimmerlampe_6.sch]
2014-02-27 Final Version. Lets hope it works...
    [Zimmerlampe_6.brd]
2014-03-06 Rearranged some files
    [Feuchtesensor_Frequenz.brd, Feuchtesensor_Frequenz.sch, RGB_Lampen_Board.brd, RGB_Lampen_Board.sch, Zimmerlampe.brd, Zimmerlampe.sch, Zimmerlampe_2.brd, Zimmerlampe_2.sch]
2014-04-04 finished the frequency_meter
    [Zimmerlampe_6.sch]
2014-04-04 removed the atmel sample for a frequency meter
2014-04-06 added most code for the communication
    [Zimmerlampe_6.sch]
2014-04-19 reworked the commands, started writing a command line communicator programm for the pc
    [colours.c, colours.h, communication.c, communication.h, humidity.c, main.c, main.cpp]
